nonarkitten/pseudo-jit/hw/Schematic_Buffee Accelerator_2023-02-03.pdf

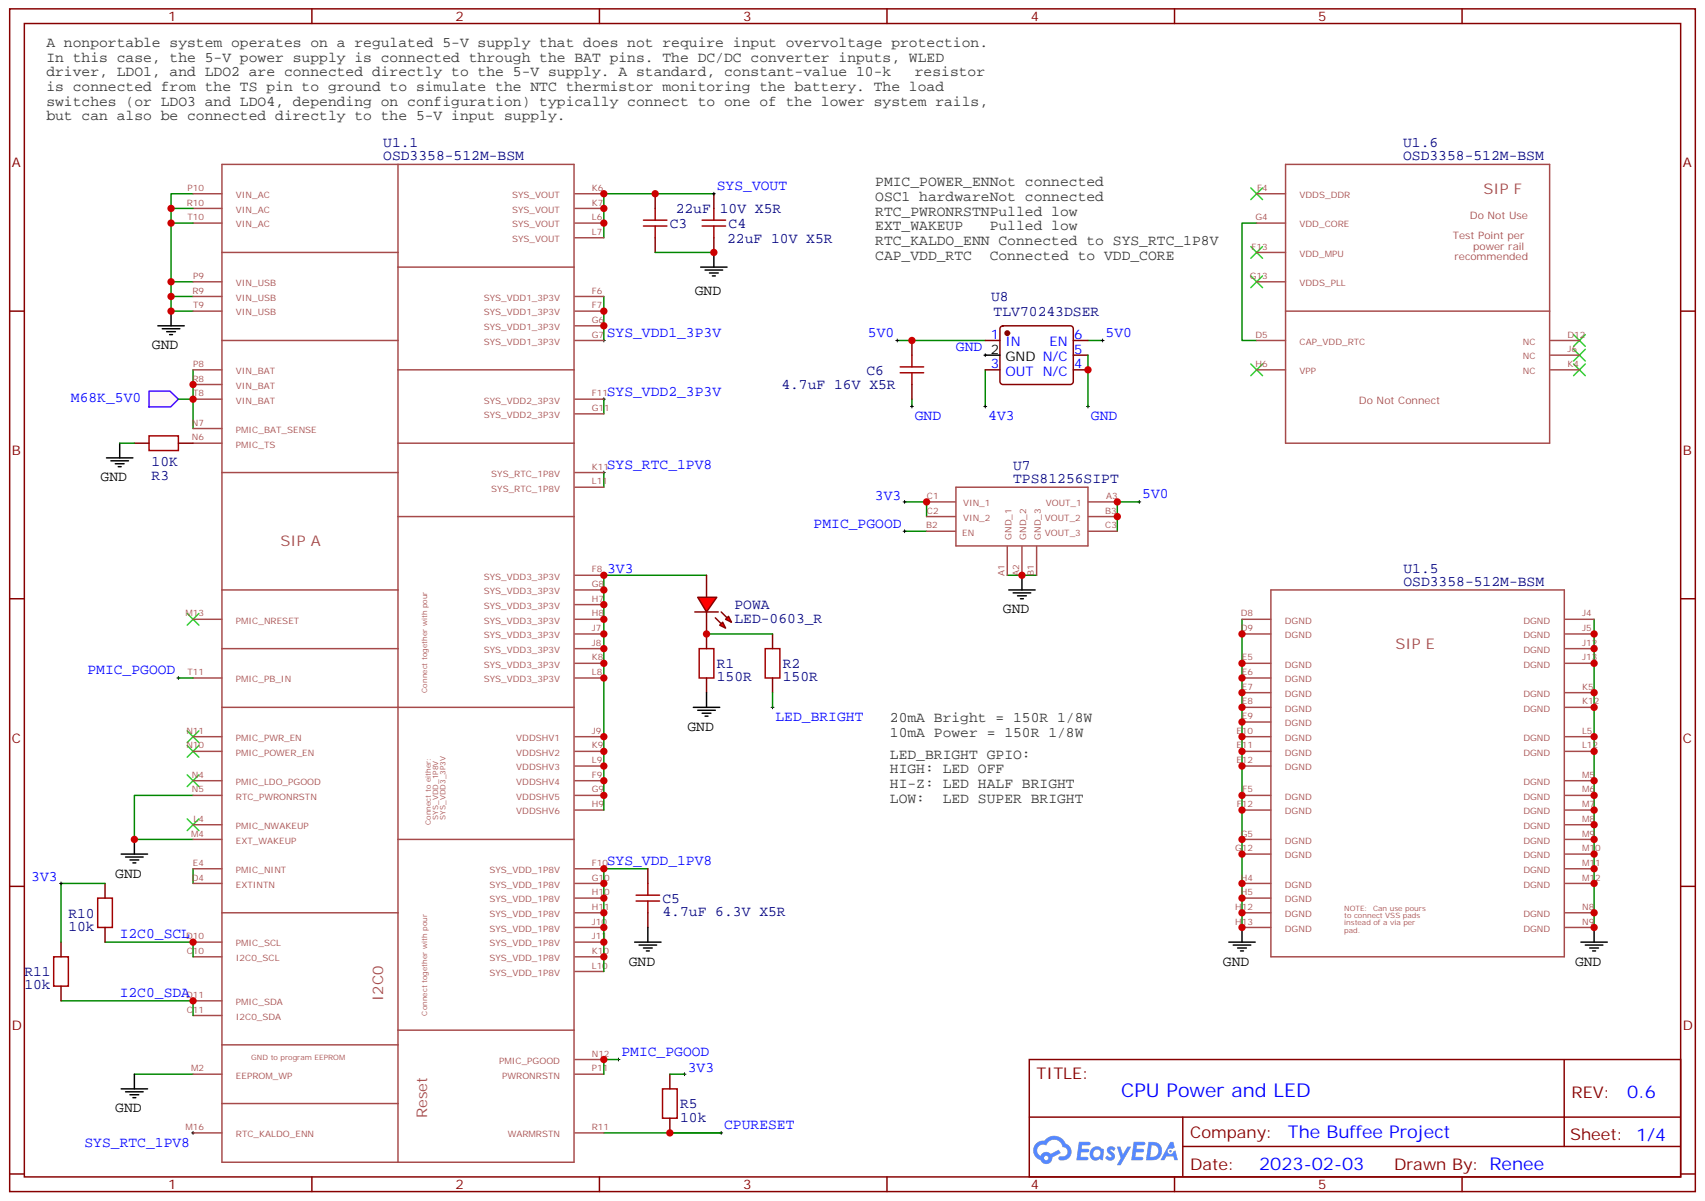
[picture p1: page 1]

A nonportable system operates on a regulated 5-V supply that does not require input overvoltage protection.
In this case, the 5-V power supply is connected through the BAT pins. The DC/DC converter inputs, WLED
is connected from the TS pin to ground to simulate the NTC thermistor monitoring the battery. The load
switches (or LDO3 and LDO4, depending on configuration) typically connect to one of the lower system rails,
but can also be connected directly to the 5-V input supply.

Connect together with pour

20mA Bright = 150R 1/8W
10mA Power = 150R 1/8W
LED_BRIGHT GPIO:
HIGH: LED OFF
HI-Z: LED HALF BRIGHT
LOW: LED SUPER BRIGHT

NOTE: Can use pours
to connect VSS pads
instead of a via per
pad.

GND to program EEPROM
EEPROM_WP

Company: The Buffee Project

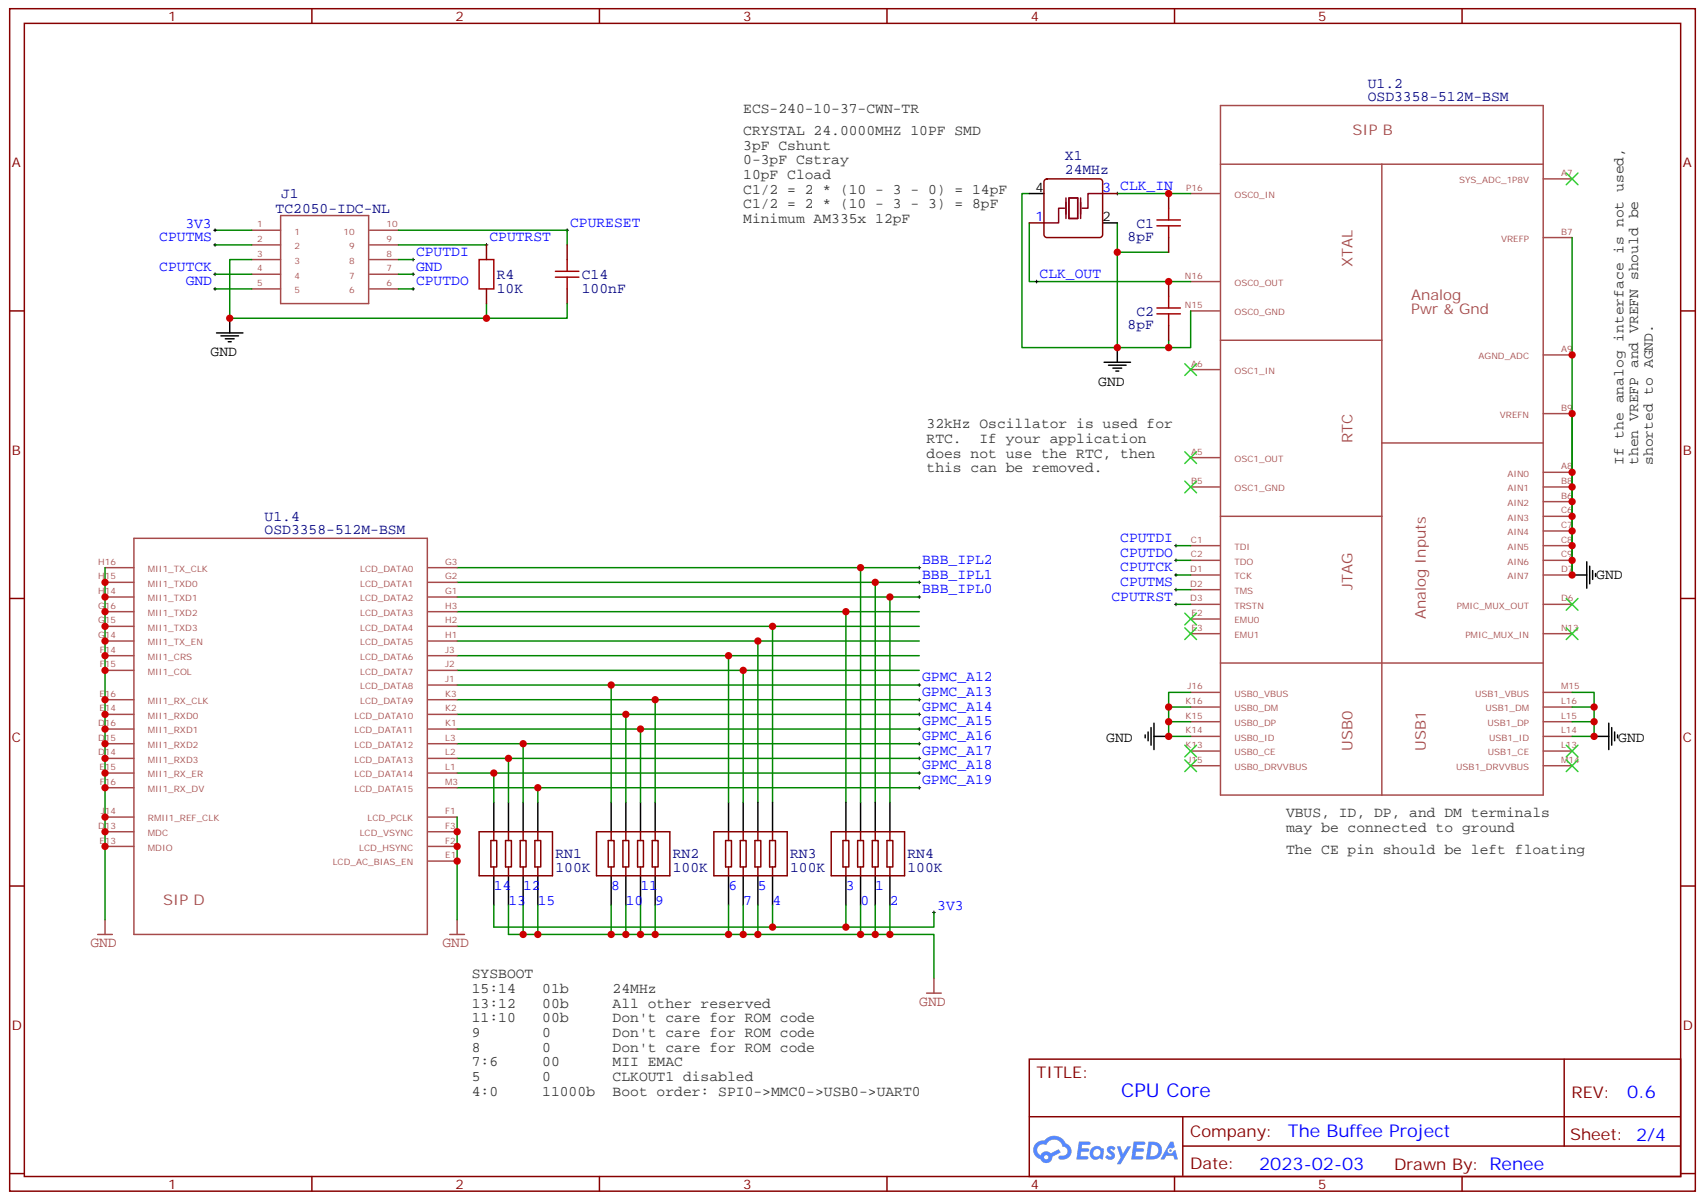
[picture p2: page 2]

If the analog interface is not used,

then VREFP and VREFN should be

32kHz Oscillator is used for
RTC. If your application
does not use the RTC, then
this can be removed.

VBUS, ID, DP, and DM terminals
may be connected to ground
The CE pin should be left floating

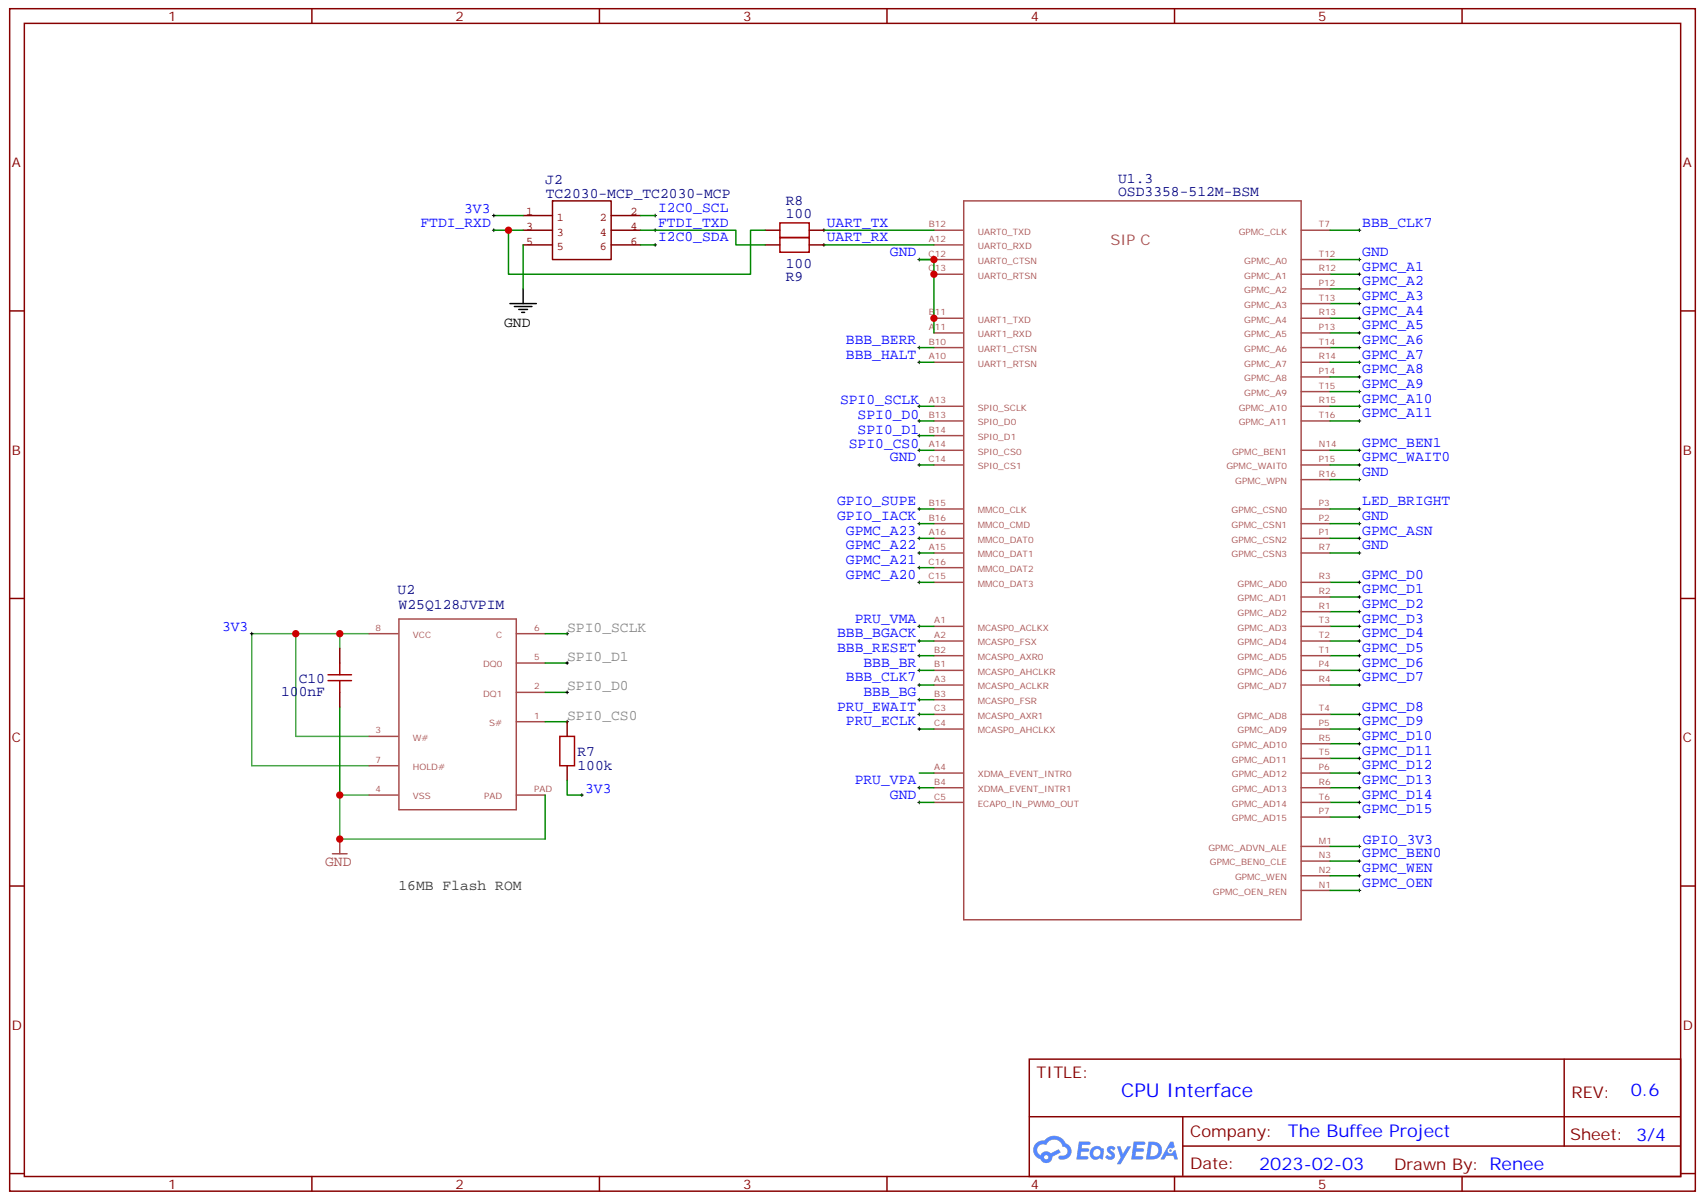
[picture p3: page 3]

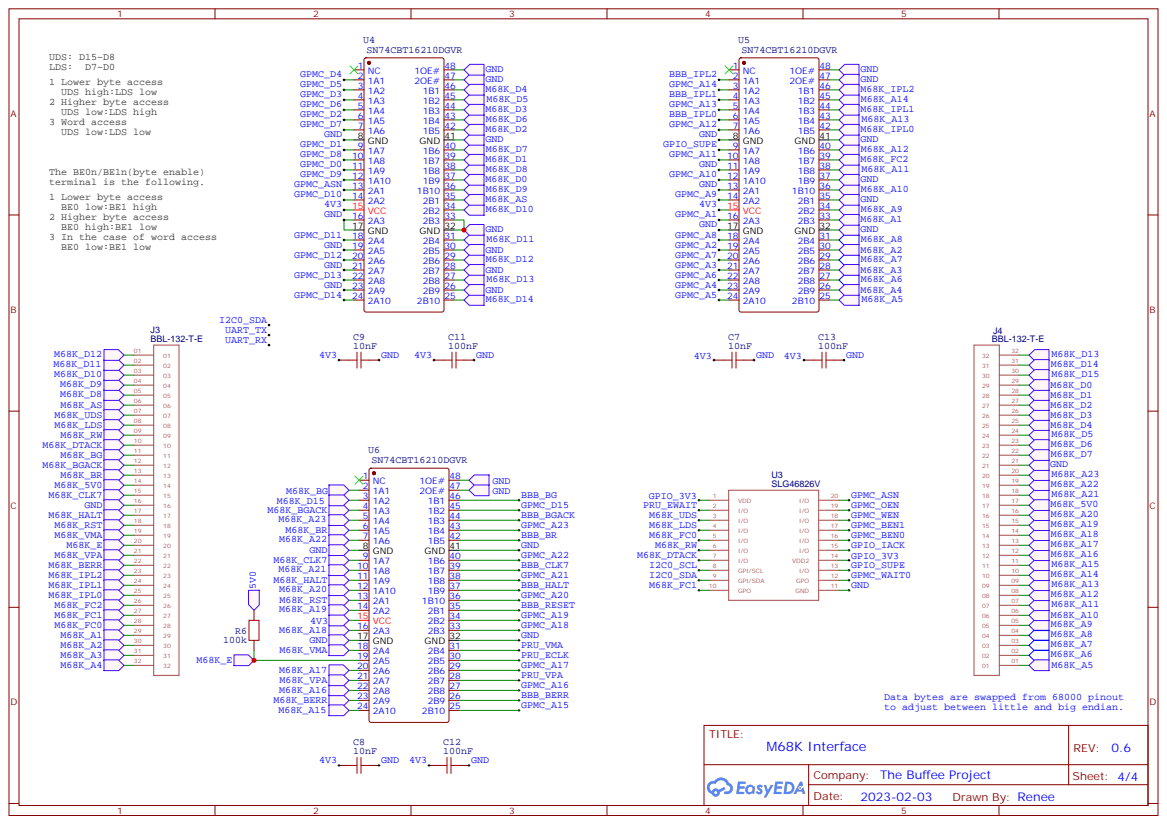
[picture p4: page 4]

UDS: D15~D8
LDS: D7~D0
1 Lower byte access
UDS high:LDS low
2 Higher byte access
UDS low:LDS high
3 Word access
UDS low:LDS low

The BE0n/BE1n(byte enable)
terminal is the following.
BE0 low:BE1 high
BE0 high:BE1 low
3 In the case of word access
BE0 low:BE1 low

Data bytes are swapped from 68000 pinout
to adjust between little and big endian.
