nonarkitten/pseudo-jit/hw/Schematic_BuffeeSwapper_2023-02-03.pdf

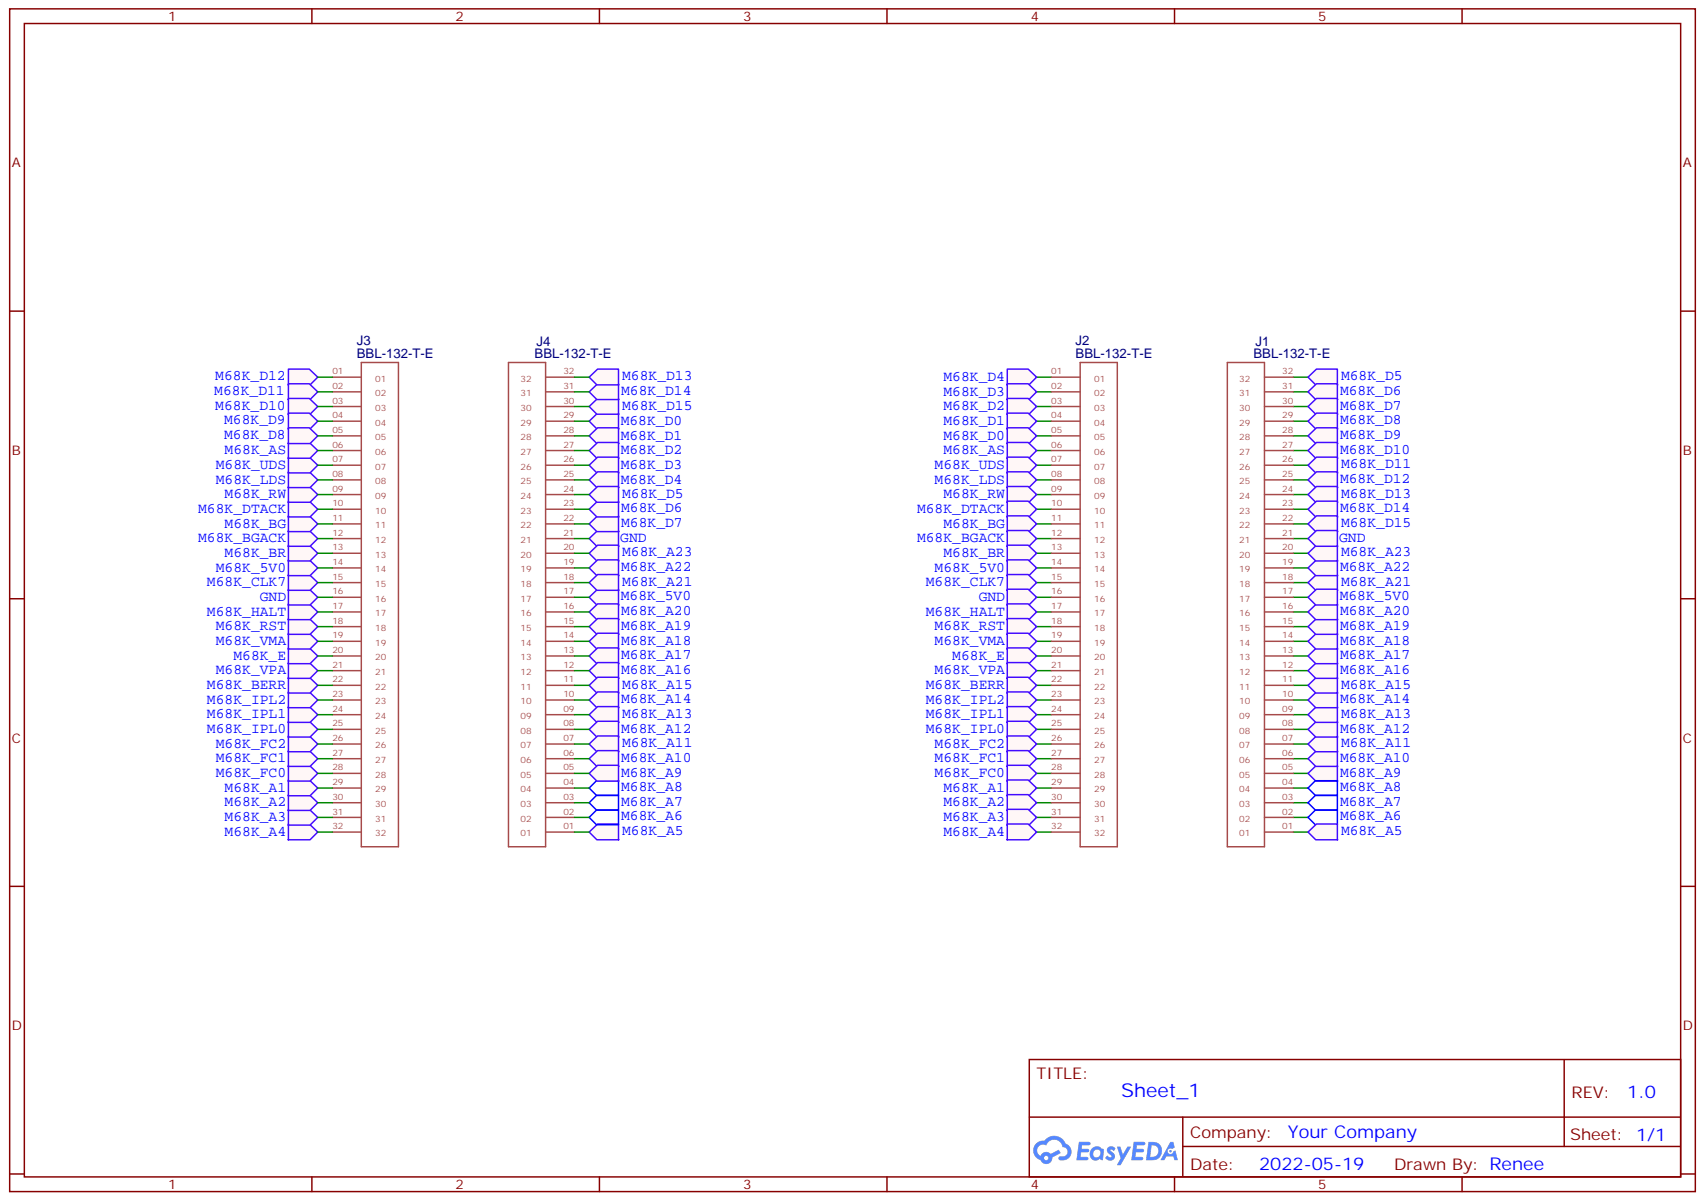
[picture p5: page 1]
