nonarkitten/pseudo-jit/inc/pinmux.h

/*
 * pinmux.h
 *
 *  Created on: May 13, 2021
 *      Author: renee.cousins
 */

#ifndef PINMUX_H_
#define PINMUX_H_

#include "main.h"

/*
 * INEN - Input Enable
 * PTDN  - Pull type Down
 * PTUP  - Pull type Up
 * PDIS  - Pull disabled
 * MX    - Mode X (0 thru 7 typically)
 * The commented string gives the final mux configuration for that pin
 */
#define PIN_CFG_INEN    (1 << 5)
#define PIN_CFG_PTDN    (0 << 3)
#define PIN_CFG_PTUP    (2 << 3)
#define PIN_CFG_PDIS    (1 << 3)

#define PIN_CFG_M0      (0 << 0)
#define PIN_CFG_M1      (1 << 0)
#define PIN_CFG_M2      (2 << 0)
#define PIN_CFG_M3      (3 << 0)
#define PIN_CFG_M4      (4 << 0)
#define PIN_CFG_M5      (5 << 0)
#define PIN_CFG_M6      (6 << 0)
#define PIN_CFG_M7      (7 << 0)

#define CFG_MOD_BASE       (0x44E10000)      //REVISIT

#define PINMUX_CONF_GPMC_AD0          (0x800)
#define PINMUX_CONF_GPMC_AD1          (0x804)
#define PINMUX_CONF_GPMC_AD2          (0x808)
#define PINMUX_CONF_GPMC_AD3          (0x80C)
#define PINMUX_CONF_GPMC_AD4          (0x810)
#define PINMUX_CONF_GPMC_AD5          (0x814)
#define PINMUX_CONF_GPMC_AD6          (0x818)
#define PINMUX_CONF_GPMC_AD7          (0x81C)
#define PINMUX_CONF_GPMC_AD8          (0x820)
#define PINMUX_CONF_GPMC_AD9          (0x824)
#define PINMUX_CONF_GPMC_AD10         (0x828)
#define PINMUX_CONF_GPMC_AD11         (0x82C)
#define PINMUX_CONF_GPMC_AD12         (0x830)
#define PINMUX_CONF_GPMC_AD13         (0x834)
#define PINMUX_CONF_GPMC_AD14         (0x838)
#define PINMUX_CONF_GPMC_AD15         (0x83C)

#define PINMUX_CONF_GPMC_A0           (0x840)
#define PINMUX_CONF_GPMC_A1           (0x844)
#define PINMUX_CONF_GPMC_A2           (0x848)
#define PINMUX_CONF_GPMC_A3           (0x84C)
#define PINMUX_CONF_GPMC_A4           (0x850)
#define PINMUX_CONF_GPMC_A5           (0x854)
#define PINMUX_CONF_GPMC_A6           (0x858)
#define PINMUX_CONF_GPMC_A7           (0x85C)
#define PINMUX_CONF_GPMC_A8           (0x860)
#define PINMUX_CONF_GPMC_A9           (0x864)
#define PINMUX_CONF_GPMC_A10          (0x868)
#define PINMUX_CONF_GPMC_A11          (0x86C)

#define PINMUX_CONF_GPMC_WAIT0        (0x870)
#define PINMUX_CONF_GPMC_WPN          (0x874)
#define PINMUX_CONF_GPMC_BEN1         (0x878)
#define PINMUX_CONF_GPMC_CSN0         (0x87C)
#define PINMUX_CONF_GPMC_CSN1         (0x880)
#define PINMUX_CONF_GPMC_CSN2         (0x884)
#define PINMUX_CONF_GPMC_CSN3         (0x888)
#define PINMUX_CONF_GPMC_CLK          (0x88C)
#define PINMUX_CONF_GPMC_ADVN_ALE     (0x890)
#define PINMUX_CONF_GPMC_OEN_REN      (0x894)
#define PINMUX_CONF_GPMC_WEN          (0x898)
#define PINMUX_CONF_GPMC_BEN0_CLE     (0x89C)

#define PINMUX_CONF_LCD_DATA0         (0x8A0)
#define PINMUX_CONF_LCD_DATA1         (0x8A4)
#define PINMUX_CONF_LCD_DATA2         (0x8A8)
#define PINMUX_CONF_LCD_DATA3         (0x8AC)
#define PINMUX_CONF_LCD_DATA4         (0x8B0)
#define PINMUX_CONF_LCD_DATA5         (0x8B4)
#define PINMUX_CONF_LCD_DATA6         (0x8B8)
#define PINMUX_CONF_LCD_DATA7         (0x8BC)
#define PINMUX_CONF_LCD_DATA8         (0x8C0)
#define PINMUX_CONF_LCD_DATA9         (0x8C4)
#define PINMUX_CONF_LCD_DATA10        (0x8C8)
#define PINMUX_CONF_LCD_DATA11        (0x8CC)
#define PINMUX_CONF_LCD_DATA12        (0x8D0)
#define PINMUX_CONF_LCD_DATA13        (0x8D4)
#define PINMUX_CONF_LCD_DATA14        (0x8D8)
#define PINMUX_CONF_LCD_DATA15        (0x8DC)

#define PINMUX_CONF_LCD_VSYNC         (0x8E0)
#define PINMUX_CONF_LCD_HSYNC         (0x8E4)
#define PINMUX_CONF_LCD_PCLK          (0x8E8)
#define PINMUX_CONF_LCD_AC_BIAS_EN    (0x8EC)

#define PINMUX_CONF_MMC0_DAT3         (0x8F0)
#define PINMUX_CONF_MMC0_DAT2         (0x8F4)
#define PINMUX_CONF_MMC0_DAT1         (0x8F8)
#define PINMUX_CONF_MMC0_DAT0         (0x8FC)
#define PINMUX_CONF_MMC0_CLK          (0x900)
#define PINMUX_CONF_MMC0_CMD          (0x904)
#define PINMUX_CONF_MII1_COL          (0x908)
#define PINMUX_CONF_MII1_CRS          (0x90C)
#define PINMUX_CONF_MII1_RX_ER        (0x910)
#define PINMUX_CONF_MII1_TX_EN        (0x914)
#define PINMUX_CONF_MII1_RX_DV        (0x918)
#define PINMUX_CONF_MII1_TXD3         (0x91C)
#define PINMUX_CONF_MII1_TXD2         (0x920)
#define PINMUX_CONF_MII1_TXD1         (0x924)
#define PINMUX_CONF_MII1_TXD0         (0x928)
#define PINMUX_CONF_MII1_TX_CLK       (0x92C)
#define PINMUX_CONF_MII1_RX_CLK       (0x930)
#define PINMUX_CONF_MII1_RXD3         (0x934)
#define PINMUX_CONF_MII1_RXD2         (0x938)
#define PINMUX_CONF_MII1_RXD1         (0x93C)
#define PINMUX_CONF_MII1_RXD0         (0x940)
#define PINMUX_CONF_RMII1_REF_CLK     (0x944)
#define PINMUX_CONF_MDIO              (0x948)
#define PINMUX_CONF_MDC               (0x94C)

#define PINMUX_CONF_SPI0_SCLK         (0x950)
#define PINMUX_CONF_SPI0_D0           (0x954)
#define PINMUX_CONF_SPI0_D1           (0x958)
#define PINMUX_CONF_SPI0_CS0          (0x95C)
#define PINMUX_CONF_SPI0_CS1          (0x960)
#define PINMUX_CONF_ECAP0_IN_PWM0_OUT (0x964)
#define PINMUX_CONF_UART0_CTSN        (0x968)
#define PINMUX_CONF_UART0_RTSN        (0x96C)
#define PINMUX_CONF_UART0_RXD         (0x970)
#define PINMUX_CONF_UART0_TXD         (0x974)
#define PINMUX_CONF_UART1_CTSN        (0x978)
#define PINMUX_CONF_UART1_RTSN        (0x97C)
#define PINMUX_CONF_UART1_RXD         (0x980)
#define PINMUX_CONF_UART1_TXD         (0x984)
#define PINMUX_CONF_I2C0_SDA          (0x988)
#define PINMUX_CONF_I2C0_SCL          (0x98C)

#define PINMUX_CONF_MCASP0_ACLKX      (0x990)
#define PINMUX_CONF_MCASP0_FSX        (0x994)
#define PINMUX_CONF_MCASP0_AXR0       (0x998)
#define PINMUX_CONF_MCASP0_AHCLKR     (0x99C)
#define PINMUX_CONF_MCASP0_ACLKR      (0x9A0)
#define PINMUX_CONF_MCASP0_FSR        (0x9A4)
#define PINMUX_CONF_MCASP0_AXR1       (0x9A8)
#define PINMUX_CONF_MCASP0_AHCLKX     (0x9AC)
#define PINMUX_CONF_XDMA_EVENT_INTR0  (0x9B0)
#define PINMUX_CONF_XDMA_EVENT_INTR1  (0x9B4)
#define PINMUX_CONF_WARMRSTN          (0x9B8)
#define PINMUX_CONF_NNMI              (0x9C0)
#define PINMUX_CONF_TMS               (0x9D0)
#define PINMUX_CONF_TDI               (0x9D4)
#define PINMUX_CONF_TDO               (0x9D8)
#define PINMUX_CONF_TCK               (0x9DC)
#define PINMUX_CONF_TRSTN             (0x9E0)
#define PINMUX_CONF_EMU0              (0x9E4)
#define PINMUX_CONF_EMU1              (0x9E8)
#define PINMUX_CONF_RTC_PWRONRSTN     (0x9F8)
#define PINMUX_CONF_PMIC_POWER_EN     (0x9FC)
#define PINMUX_CONF_EXT_WAKEUP        (0xA00)
#define PINMUX_CONF_USB0_DRVVBUS      (0xA1C)
#define PINMUX_CONF_USB1_DRVVBUS      (0xA34)

typedef struct {
    uint32_t offset;
    uint32_t val;
} pin_muxing_t;

extern void config_mux(const pin_muxing_t* pin_mux);

#endif /* PINMUX_H_ */
