nonarkitten/pseudo-jit/pru/inc/pru_intc.h

/*
 * Copyright (C) 2015 Texas Instruments Incorporated - http://www.ti.com/
 *
 *
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
 *	* Redistributions of source code must retain the above copyright
 *	  notice, this list of conditions and the following disclaimer.
 *
 *	* Redistributions in binary form must reproduce the above copyright
 *	  notice, this list of conditions and the following disclaimer in the
 *	  documentation and/or other materials provided with the
 *	  distribution.
 *
 *	* Neither the name of Texas Instruments Incorporated nor the names of
 *	  its contributors may be used to endorse or promote products derived
 *	  from this software without specific prior written permission.
 *
 * THIS SOFTWARE IS PROVIDED BY THE COPYRIGHT HOLDERS AND CONTRIBUTORS
 * "AS IS" AND ANY EXPRESS OR IMPLIED WARRANTIES, INCLUDING, BUT NOT
 * LIMITED TO, THE IMPLIED WARRANTIES OF MERCHANTABILITY AND FITNESS FOR
 * A PARTICULAR PURPOSE ARE DISCLAIMED. IN NO EVENT SHALL THE COPYRIGHT
 * OWNER OR CONTRIBUTORS BE LIABLE FOR ANY DIRECT, INDIRECT, INCIDENTAL,
 * SPECIAL, EXEMPLARY, OR CONSEQUENTIAL DAMAGES (INCLUDING, BUT NOT
 * LIMITED TO, PROCUREMENT OF SUBSTITUTE GOODS OR SERVICES; LOSS OF USE,
 * DATA, OR PROFITS; OR BUSINESS INTERRUPTION) HOWEVER CAUSED AND ON ANY
 * THEORY OF LIABILITY, WHETHER IN CONTRACT, STRICT LIABILITY, OR TORT
 * (INCLUDING NEGLIGENCE OR OTHERWISE) ARISING IN ANY WAY OUT OF THE USE
 * OF THIS SOFTWARE, EVEN IF ADVISED OF THE POSSIBILITY OF SUCH DAMAGE.
 */

#ifndef _PRU_INTC_H_
#define _PRU_INTC_H_

/* PRU INTC register set */
typedef struct {

	/* PRU_INTC_REVID register bit field */
	union {
		volatile uint32_t REVID;

		volatile struct {
			unsigned REV_MINOR : 6;		// 5:0
			unsigned REV_CUSTOM : 2;	// 7:6
			unsigned REV_MAJOR : 3;		// 10:8
			unsigned REV_RTL : 5;		// 15:11
			unsigned REV_MODULE : 12;	// 27:16
			unsigned rsvd28 : 2;		// 29:28
			unsigned REV_SCHEME : 2;	// 31:30
		} REVID_bit;
	};	// 0x0


	/* PRU_INTC_CR register bit field */
	union {
		volatile uint32_t CR;

		volatile struct {
			unsigned rsvd0 : 2;		// 1:0
			unsigned NEST_MODE : 2;		// 3:2
			unsigned rsvd4 : 28;		// 31:4
		} CR_bit;
	};	// 0x4


	uint32_t rsvd8[2];		// 0x8 - 0xC


	/* PRU_INTC_GER register bit field */
	union {
		volatile uint32_t GER;

		volatile struct {
			unsigned EN_HINT_ANY : 1;	// 0
			unsigned rsvd1 : 31;		// 31:1
		} GER_bit;
	};	// 0x10


	uint32_t rsvd14[2];	// 0x14 - 0x18


	/* PRU_INTC_GNLR register bit field */
	union {
		volatile uint32_t GNLR;

		volatile struct {
			unsigned GLB_NEST_LEVEL : 9;	// 8:0
			unsigned rsvd9 : 22;		// 30:9
			unsigned AUTO_OVERRIDE : 1;	// 31
		} GNLR_bit;
	};	// 0x1C


	/* PRU_INTC_SISR register bit field */
	union {
		volatile uint32_t SISR;

		volatile struct {
			unsigned STS_SET_IDX : 10;	// 9:0
			unsigned rsvd10 : 22;		// 31:10
		} SISR_bit;
	};	// 0x20


	/* PRU_INTC_SICR register bit field */
	union {
		volatile uint32_t SICR;

		volatile struct {
			unsigned STS_CLR_IDX : 10;	// 9:0
			unsigned rsvd10 : 22;		// 31:10
		} SICR_bit;
	};	// 0x24


	/* PRU_INTC_EISR register bit field */
	union {
		volatile uint32_t EISR;

		volatile struct {
			unsigned EN_SET_IDX : 10;	// 9:0
			unsigned rsvd10 : 22;		// 31:10
		} EISR_bit;
	};	// 0x28


	/* PRU_INTC_EICR register bit field */
	union {
		volatile uint32_t EICR;

		volatile struct {
			unsigned EN_CLR_IDX : 10;	// 9:0
			unsigned rsvd10 : 22;		// 31:10
		} EICR_bit;
	};	// 0x2C


	uint32_t rsvd30;	// 0x30


	/* PRU_INTC_HIEISR register bit field */
	union {
		volatile uint32_t HIEISR;

		volatile struct {
			unsigned HINT_EN_SET_IDX : 4;	// 3:0
			unsigned rsvd4 : 28;		// 31:4
		} HIEISR_bit;
	};	// 0x34


	/* PRU_INTC_HIDISR register bit field */
	union {
		volatile uint32_t HIDISR;

		volatile struct {
			unsigned HINT_EN_CLR_IDX : 4;	// 3:0
			unsigned rsvd4 : 28;		// 31:4
		} HIDISR_bit;
	};	// 0x38


	uint32_t rsvd3C[17];	// 0x3C - 0x7C


	/* PRU_INTC_GPIR register bit field */
	union {
		volatile uint32_t GPIR;

		volatile struct {
			unsigned GLB_PRI_INTR : 10;	// 9:0
			unsigned rsvd10 : 21;		// 30:10
			unsigned GLB_NONE : 1;		// 31
		} GPIR_bit;
	};	// 0x80


	uint32_t rsvd84[95];	// 0x84 - 0x1FC


	/* PRU_INTC_SRSR0 register bit field */
	union {
		volatile uint32_t SRSR0;

		volatile struct {
			unsigned RAW_STS_31_0 : 32;	// 31:0
		} SRSR0_bit;
	};	// 0x200


	/* PRU_INTC_SRSR1 register bit field */
	union {
		volatile uint32_t SRSR1;

		volatile struct {
			unsigned RAW_STS_63_32 : 32;	// 31:0
		} SRSR1_bit;
	};	// 0x204


	uint32_t rsvd208[30];	// 0x208 - 0x27C


	/* PRU_INTC_SECR0 register bit field */
	union {
		volatile uint32_t SECR0;

		volatile struct {
			unsigned ENA_STS_31_0 : 32;	// 31:0
		} SECR0_bit;
	};	// 0x280


	/* PRU_INTC_SECR1 register bit field */
	union {
		volatile uint32_t SECR1;

		volatile struct {
			unsigned ENA_STS_63_32 : 32;	// 31:0
		} SECR1_bit;
	};	// 0x284


	uint32_t rsvd288[30];	// 0x288 - 0x2FC


	/* PRU_INTC_ESR0 register bit field */
	union {
		volatile uint32_t ESR0;

		volatile struct {
			unsigned EN_SET_31_0 : 32;	// 31:0
		} ESR0_bit;
	};	// 0x300


	/* PRU_INTC_ESR1 register bit field */
	union {
		volatile uint32_t ESR1;

		volatile struct {
			unsigned EN_SET_63_32 : 32;	// 31:0
		} ESR1_bit;
	};	// 0x304


	uint32_t rsvd308[30];	// 0x308 - 0x37C


	/* PRU_INTC_ECR0 register bit field */
	union {
		volatile uint32_t ECR0;

		volatile struct {
			unsigned EN_CLR_31_0 : 32;	// 31:0
		} ECR0_bit;
	};	// 0x380


	/* PRU_INTC_ECR1 register bit field */
	union {
		volatile uint32_t ECR1;

		volatile struct {
			unsigned EN_CLR_63_32 : 32;	// 31:0
		} ECR1_bit;
	};	// 0x384


	uint32_t rsvd388[30];	// 0x388 - 0x3FC


	/* PRU_INTC_CMR0 register bit field */
	union {
		volatile uint32_t CMR0;

		volatile struct {
			unsigned CH_MAP_0 : 4;		// 3:0
			unsigned rsvd4 : 4;		// 7:4
			unsigned CH_MAP_1 : 4;		// 11:8
			unsigned rsvd12 : 4;		// 15:12
			unsigned CH_MAP_2 : 4;		// 19:16
			unsigned rsvd20 : 4;		// 23:20
			unsigned CH_MAP_3 : 4;		// 27:24
			unsigned rsvd28 : 4;		// 31:28
		} CMR0_bit;
	};	// 0x400


	/* PRU_INTC_CMR1 register bit field */
	union {
		volatile uint32_t CMR1;

		volatile struct {
			unsigned CH_MAP_4 : 4;		// 3:0
			unsigned rsvd4 : 4;		// 7:4
			unsigned CH_MAP_5 : 4;		// 11:8
			unsigned rsvd12 : 4;		// 15:12
			unsigned CH_MAP_6 : 4;		// 19:16
			unsigned rsvd20 : 4;		// 23:20
			unsigned CH_MAP_7 : 4;		// 27:24
			unsigned rsvd28 : 4;		// 31:28
		} CMR1_bit;
	};	// 0x404


	/* PRU_INTC_CMR2 register bit field */
	union {
		volatile uint32_t CMR2;

		volatile struct {
			unsigned CH_MAP_8 : 4;		// 3:0
			unsigned rsvd4 : 4;		// 7:4
			unsigned CH_MAP_9 : 4;		// 11:8
			unsigned rsvd12 : 4;		// 15:12
			unsigned CH_MAP_10 : 4;		// 19:16
			unsigned rsvd20 : 4;		// 23:20
			unsigned CH_MAP_11 : 4;		// 27:24
			unsigned rsvd28 : 4;		// 31:28
		} CMR2_bit;
	};	// 0x408


	/* PRU_INTC_CMR3 register bit field */
	union {
		volatile uint32_t CMR3;

		volatile struct {
			unsigned CH_MAP_12 : 4;		// 3:0
			unsigned rsvd4 : 4;		// 7:4
			unsigned CH_MAP_13 : 4;		// 11:8
			unsigned rsvd12 : 4;		// 15:12
			unsigned CH_MAP_14 : 4;		// 19:16
			unsigned rsvd20 : 4;		// 23:20
			unsigned CH_MAP_15 : 4;		// 27:24
			unsigned rsvd28 : 4;		// 31:28
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
	union {
		volatile uint32_t HIER;

		volatile struct {
			unsigned EN_HINT : 10;	// 9:0
			unsigned rsvd9 : 22;		// 31:10
		} HIER_bit;
	};	// 0x1500

} pruIntc;

volatile __far pruIntc CT_INTC __attribute__((cregister("PRU_INTC", far), peripheral));

#endif /* _PRU_INTC_H_ */
