nonarkitten/pseudo-jit/(commit log)

2020-10-06 Updating towards current spec from direct thread
2021-02-07 Add v0.2 hw
    [BOM_Buffee Accelerator_2021-02-03_21-21-13_PCBWay.csv, BOM_Buffee Accelerator_2021-02-06_22-59-37.csv, PickAndPlace_PCB_2021-02-03_21-22-12.csv, PickAndPlace_PCB_2021-02-06_23-00-42.csv]
2021-04-14 Major overhaul
    [BOM_Buffee Accelerator_2021-02-03_21-21-13_PCBWay.csv, BOM_Buffee Accelerator_2021-02-06_22-59-37.csv, PickAndPlace_PCB_2021-02-03_21-22-12.csv, PickAndPlace_PCB_2021-02-06_23-00-42.csv]
2021-07-07 Major rework underway (doesn't compile)
    [config.h, cstd.c, main.c, main.h, pinmux.c]
2021-09-13 Switch to asm PJIT
2022-01-27 PJIT Builds, doesn't do anything useful yet
    [bogomips_arm.c, cp15.h, cstd.c, main.c, main.h, pinmux.c, pinmux.h]
2022-01-28 Builds more correctly; squeezed some ARM opcodes out
    [cstd.c, main.c, printf.c]
2023-01-19 Reworked, including arm.h
2023-01-19 Fixed up ea for new arm.h
2023-01-20 replaced hex codes with arm.h, cleaned formatting
2023-01-20 Fix for missing PRU submake, including some more updates
    [main.c]
2023-02-03 Add prelim SVC handler and SPI wirte
2023-02-03 Create empty.txt (#22)
    * Create empty.txt
    * Add files via upload
    Adding latest schematics (not full BOM though!)
2023-02-24 More bi-endian fixes, port init from test.
    [hw_ddr.c, hw_mmu.c, main.c, main.h, pinmux.c, writeimage.c]
2023-04-05 Add Arduino programmer
2023-04-06 SPI boot mostly works (PRU won't init)
    [main.c, writeimage.c]
2023-04-06 Added Emerg. Erase. Better CLK code. Faster SPI. Better PLL. L3L4 Wakeup
2023-04-06 Commit before Starterware rework
    [hw_init.c, main.c]
2023-04-11 EEPROM is writing, stabler I2C code, PMIC check, config in, more stack room, fixed __offsetof, made CPU * POST settings bitfields
    [cp15.h, gpak.c, hw_init.c, hw_init.h, init_power.c, main.c, main.h]
2023-04-11 PJIT cache init working, I2C a little more stable, added reworked PJIT code back in
    [config.c, gpak.c, main.c]
2023-04-11 Clean up. Fixed vscode intellisense.
    [gpak.h, greenpak.ino, main.c, main.h, writeimage.c, xmodem.c]
2023-04-11 Working GreenPAK, broke up hw_init
    [clocks.c, config.c, ddr_emif.c, dmtimer.c, flash.c, gpak.c, gpio.c]
2023-04-17 Initial support for Buffee boards without their Katra
2023-04-17 Fixed IPL GPIO code
    [gpio.c]
2023-05-04 More tests for GPMC, down to ~3% error rate
    [gpak.c, gpmc.c]
2023-05-04 Zero GPMC errors (at least once!)
    [gpmc.c]
2023-05-12 Major rework for new stateful GreenPAK (untested)
    [gpak.c, gpmc.c, main.c, pru_registers.h]
2024-01-10 Fix address offsets for word access
    [pru_registers.h]
2024-03-22 Cleaned up make (no longer needs multiple runs on PRU edits), added timestamps for boot printf, current GreenPAK code, more debug noise, faster init, bugfix in disassem, faster opcode emitter (68K on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
    [gpak.c, gpmc.c, i2c.h, main.c]
2025-07-06 Fix up from bad merge
    [main.c]
